questionable-innovations/arcade-chess/docs/WhitePCB_RedGreen.png

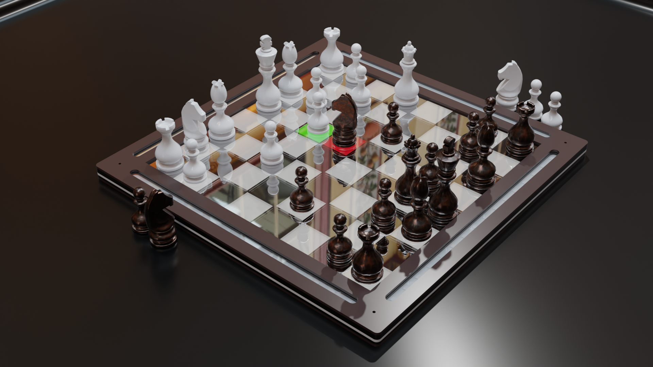
docs/WhitePCB_RedGreen.png
