questionable-innovations/arcade-chess/docs/WoodBoard.webp

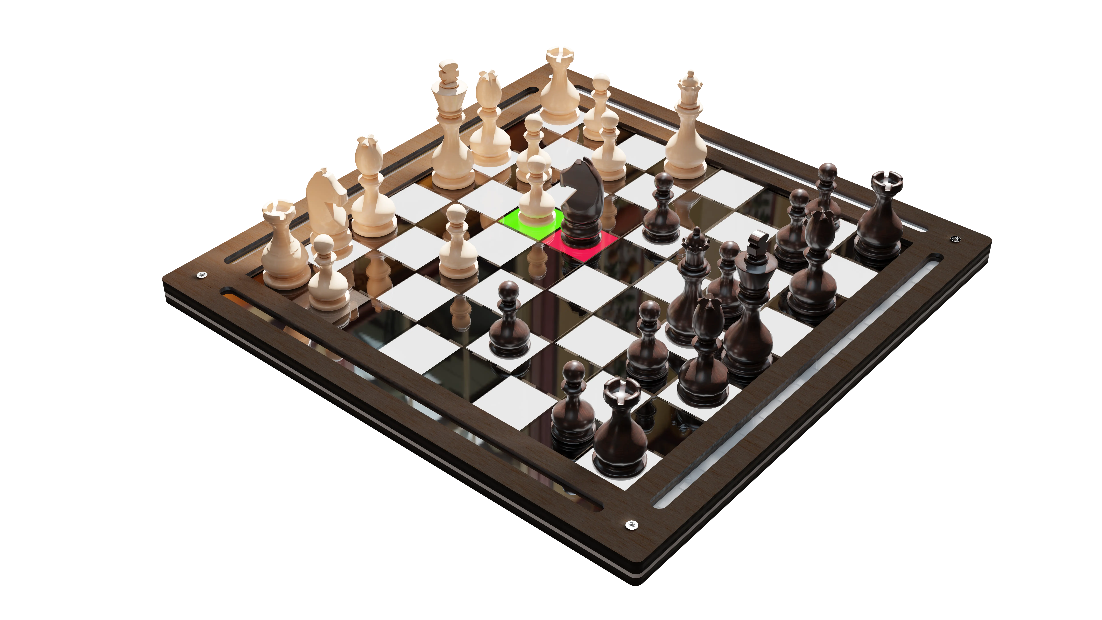
docs/WoodBoard.webp
