questionable-innovations/arcade-chess/docs/PCB-3D.png

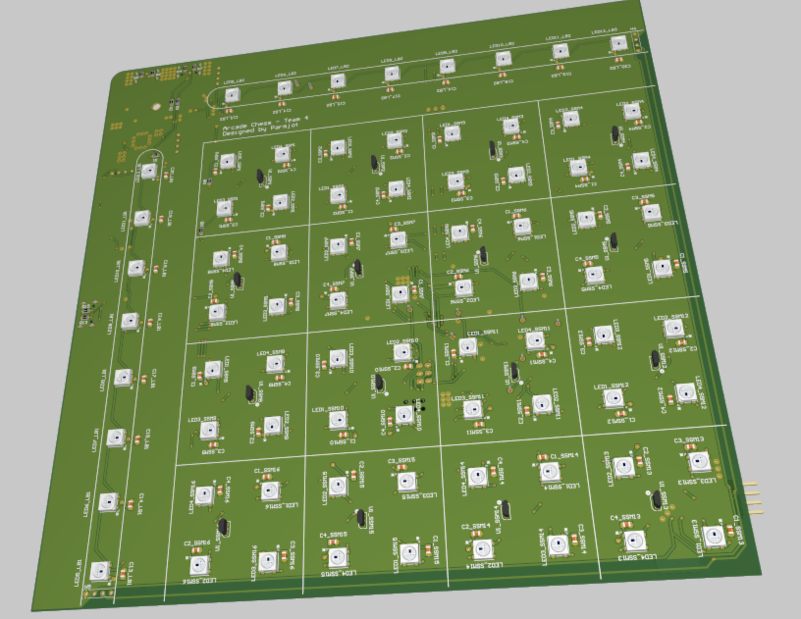
docs/PCB-3D.png
