questionable-innovations/arcade-chess/docs/TeamTwo_ArcadeChess.pdf

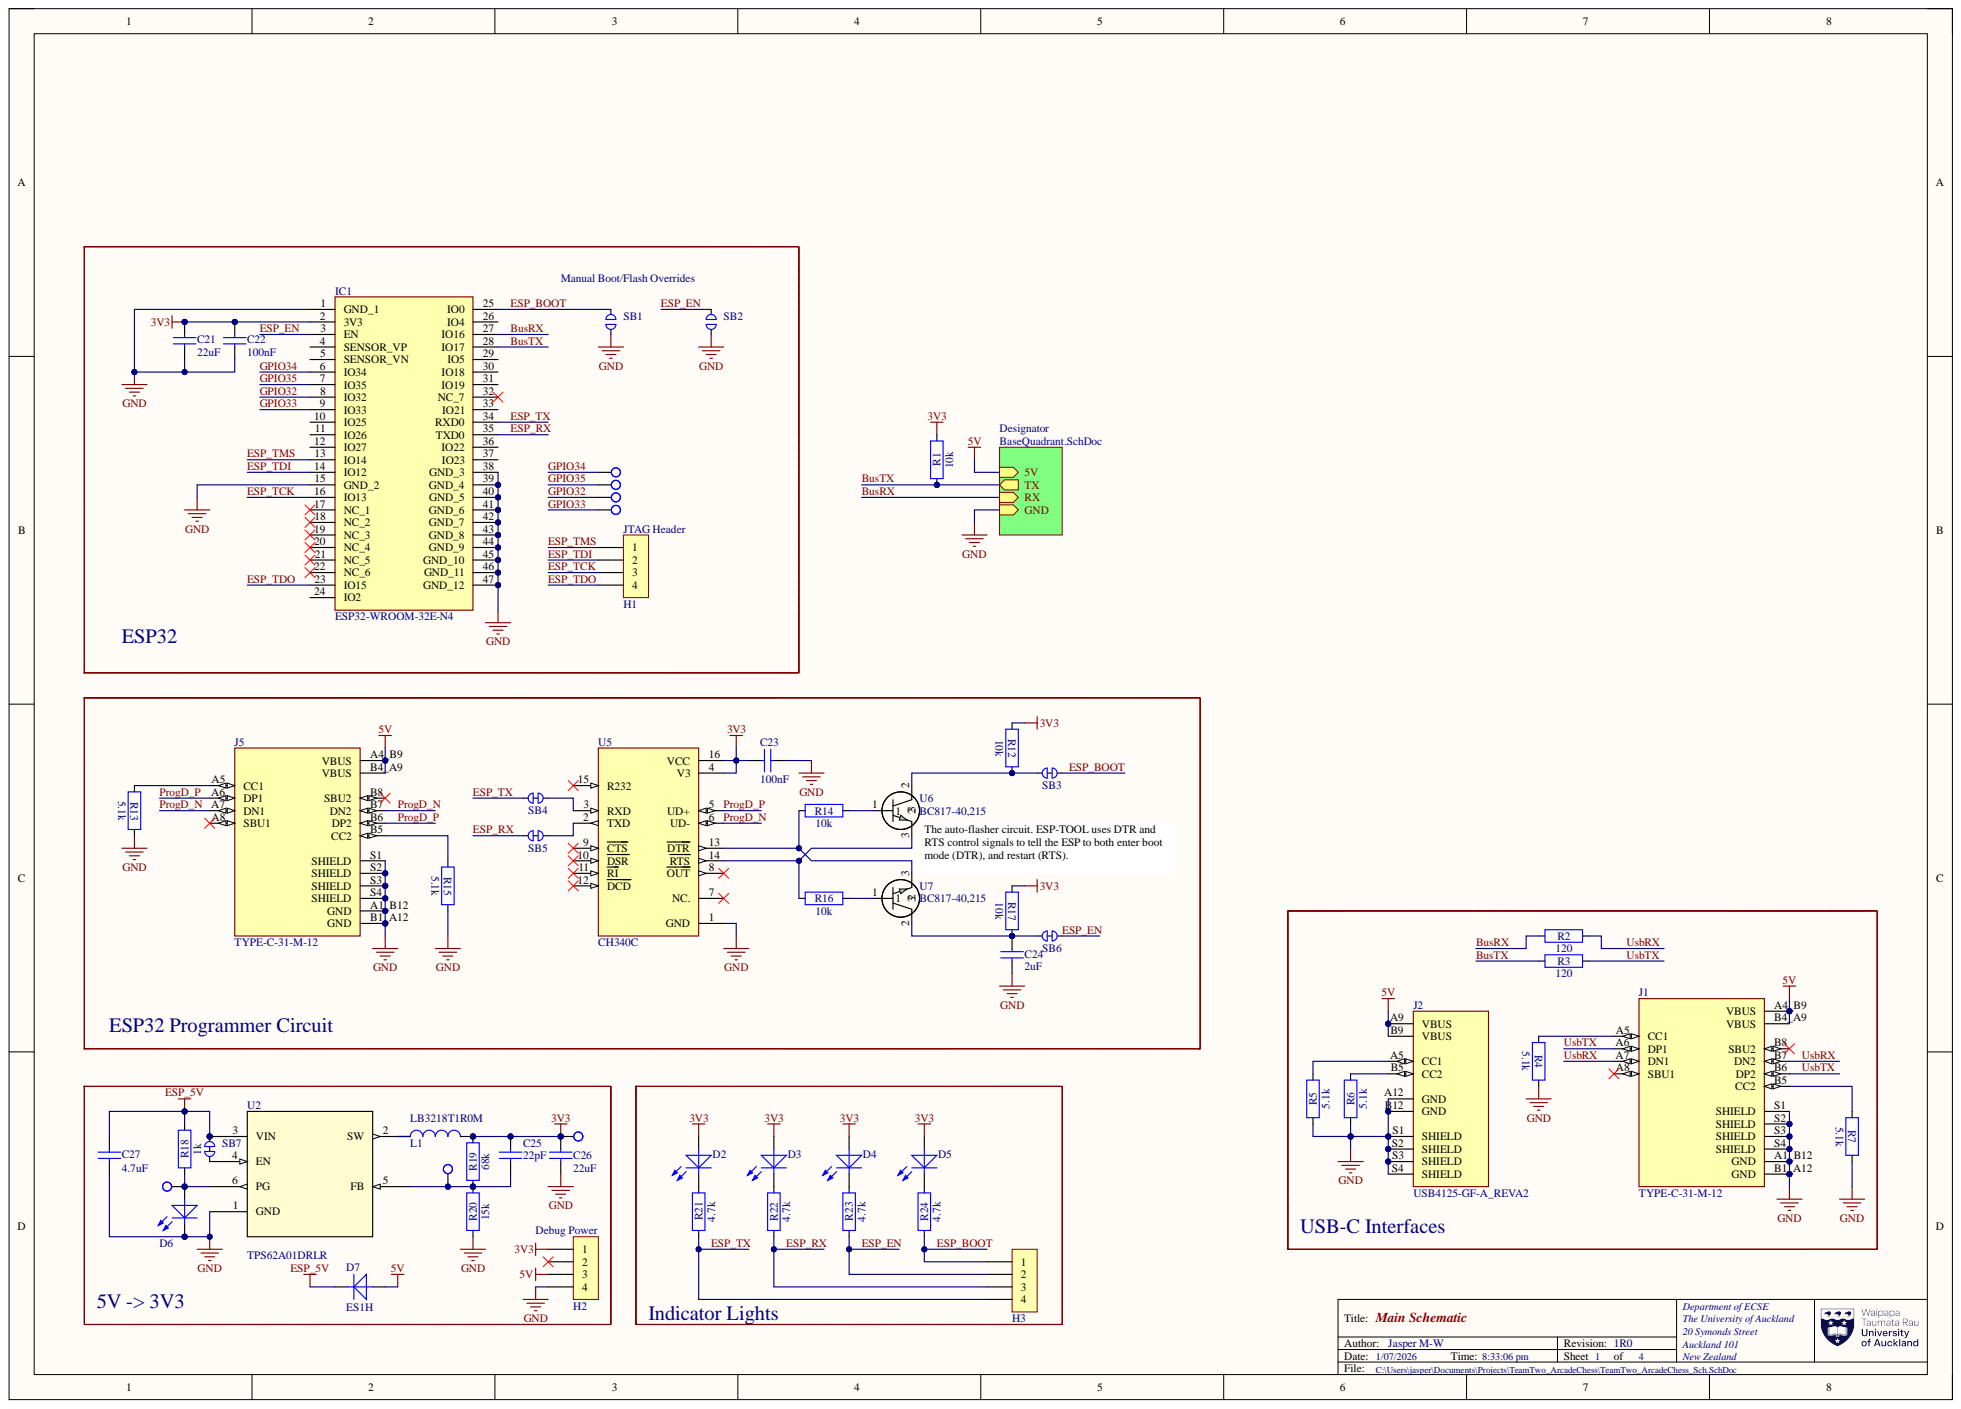
[picture p4: page 1]

C2 1 | ESP_E N C2 | 3

signals to tell the

ESP-TOOL uses DTR and
ESP to both enter boot

mode (DTR), and restart (R

GND A12 GND B12

Department of ECSE
The University of Auckland
20 Symonds Street
Auckland 101

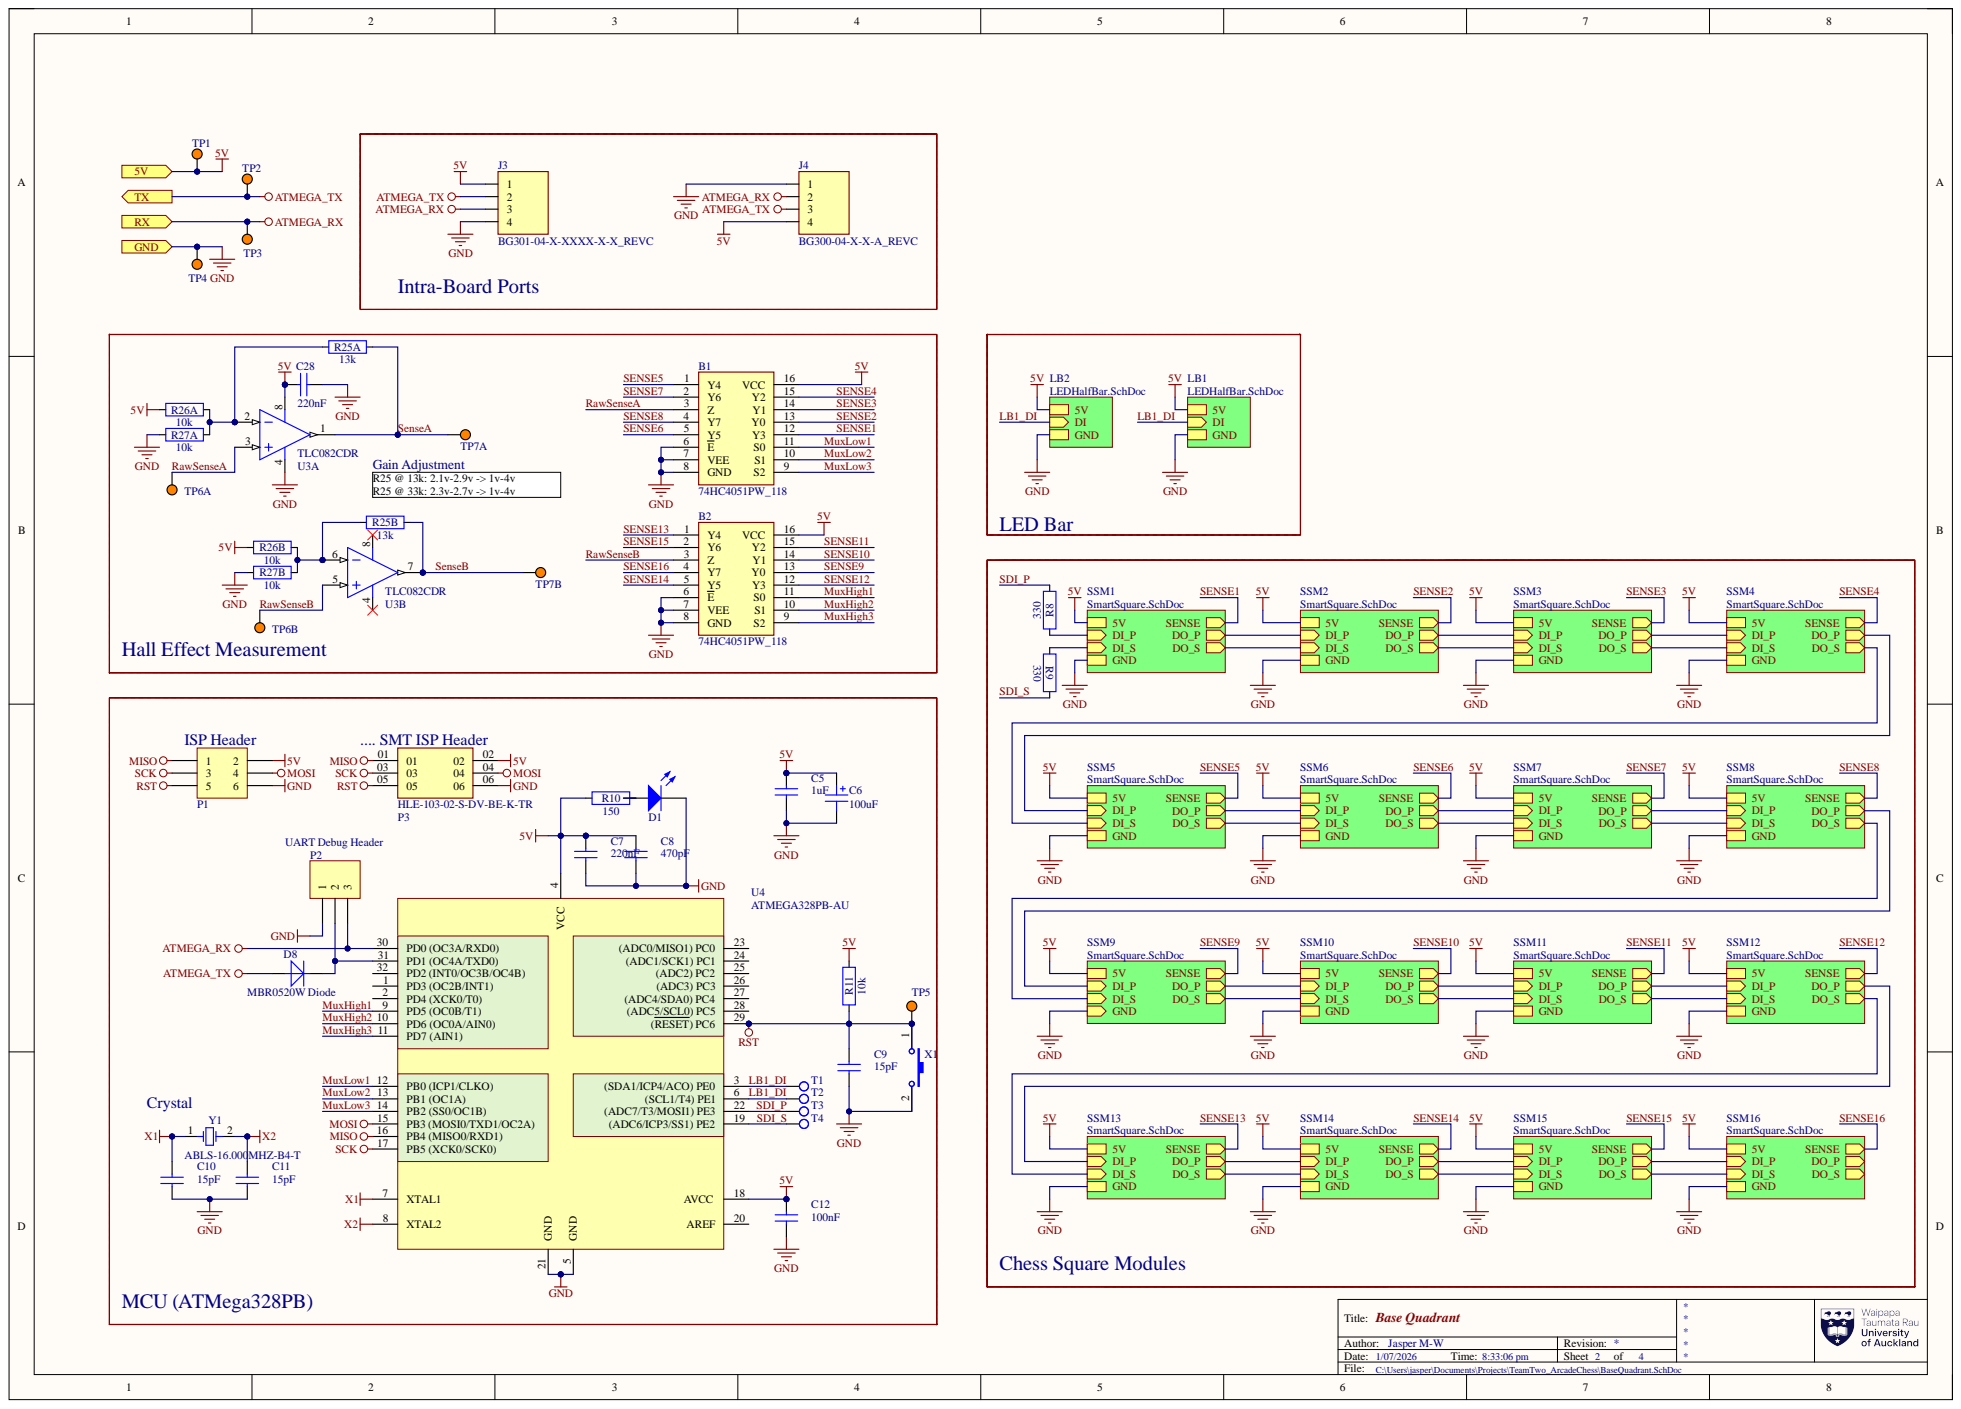
[picture p5: page 2]

HLE-103-02-S-DV-BE-K-TR

Jasper M-W
C:\Users\jasper\Documents\Projects\TeamTwo_ArcadeChess\BaseQuadrant.SchDoc

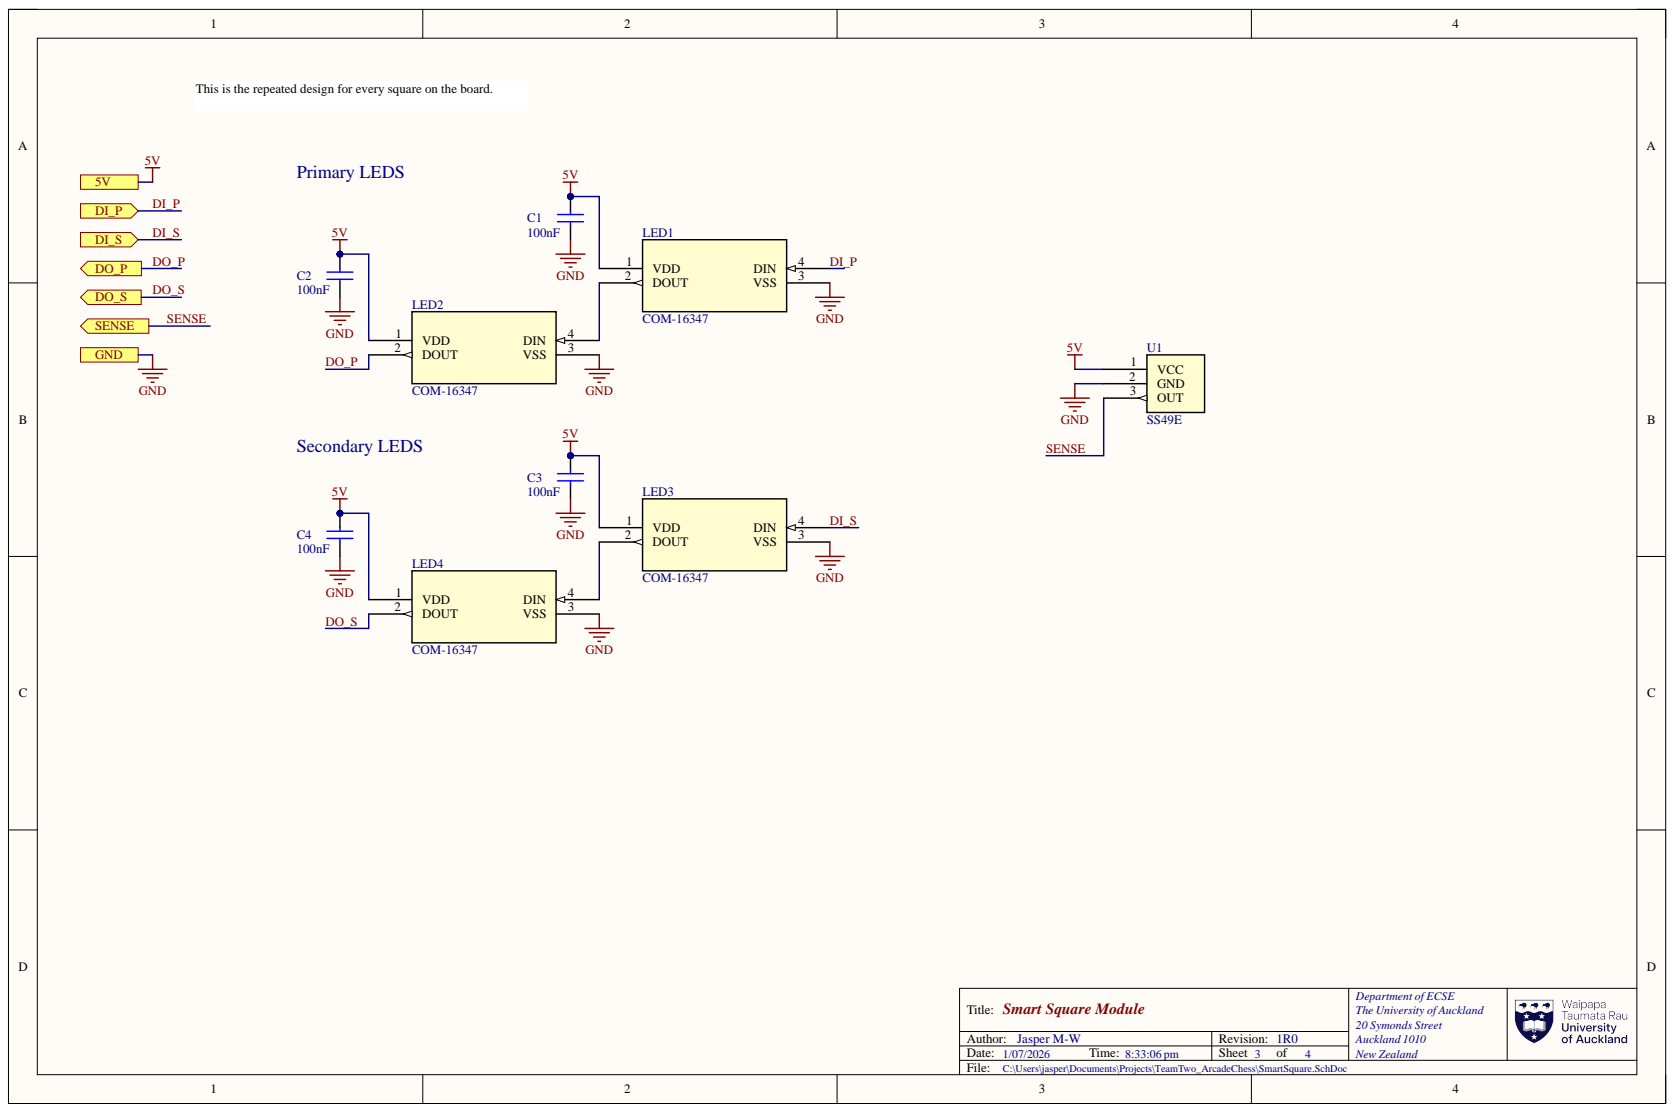
[picture p6: page 3]

This is the repeated design for every square on the board.

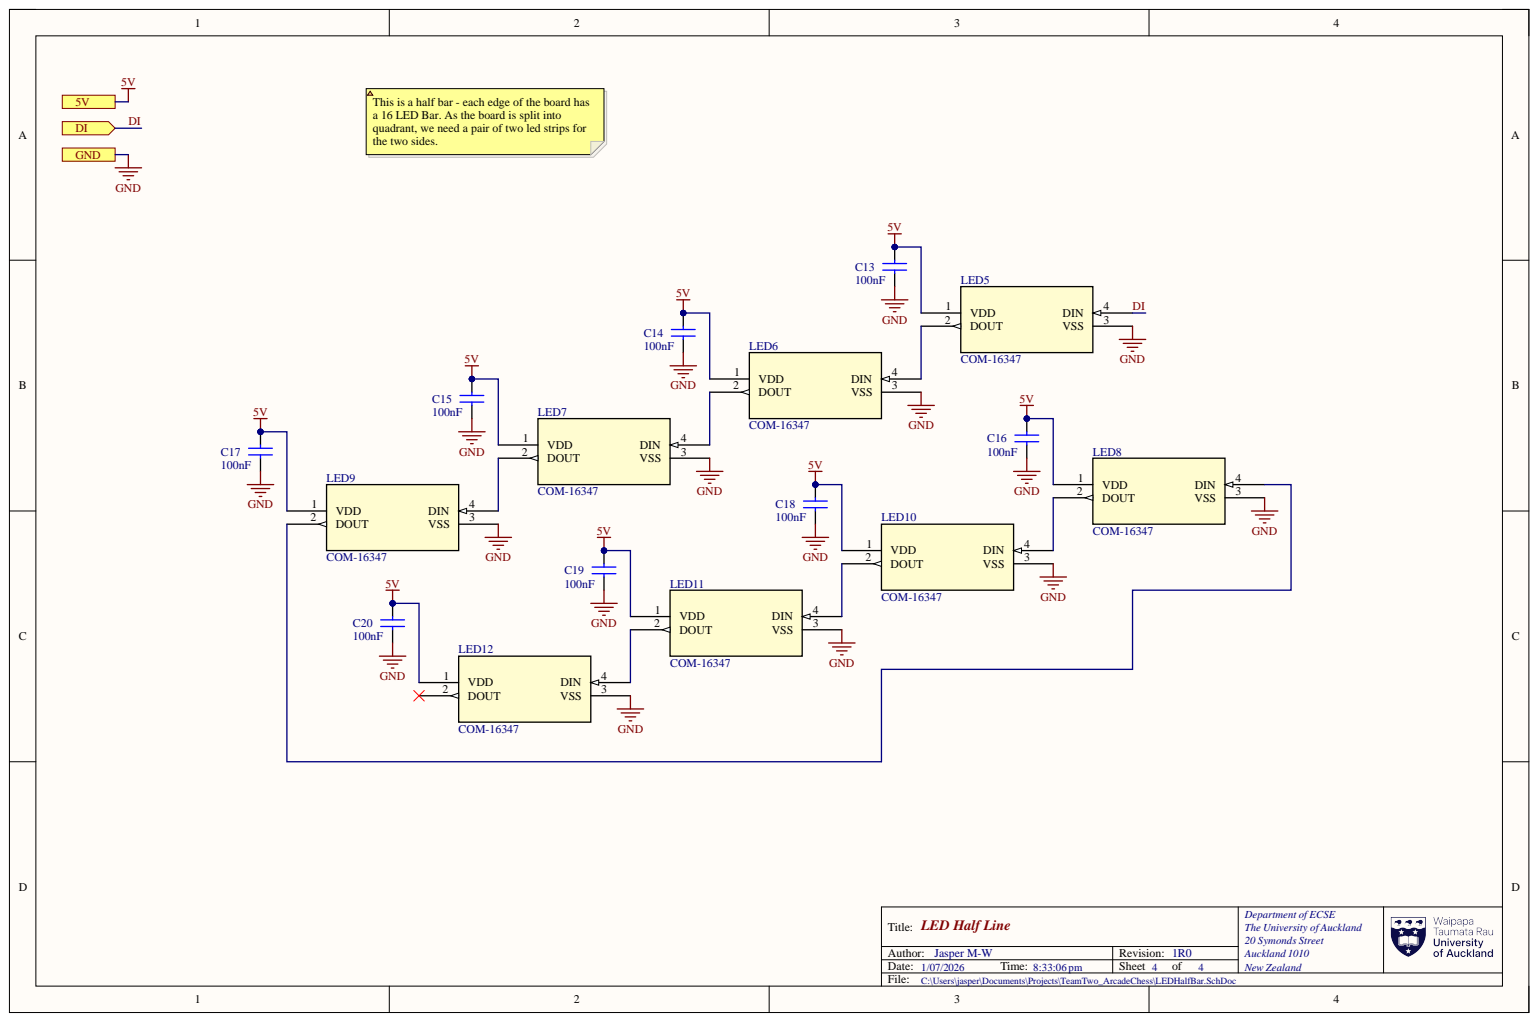
[picture p7: page 4]

This is a half bar - each edge of the board has
a 16 LED Bar. As the board is split into
quadrant, we need a pair of two led strips for
the two sides.

Department of ECSE
The University of Auckland
20 Symonds Street
Auckland 1010

Jasper M-W
C:\Users\jasper\Documents\Projects\TeamTwo_ArcadeChess\LEDHalfBar.SchDoc
