questionable-innovations/arcade-chess/server/src/game/positions.rs

//! The puzzle deck.
//!
//! The miner (`position-miner/`) already produces exactly what puzzle mode
//! needs and already emits JSON, so the contract with that workstream is one
//! command:
//!
//! ```sh
//! arcpos dump position-miner/data/curated.arcpos --json -n 100000 \
//!     > server/positions.json
//! ```
//!
//! Note `-n` defaults to 20 (`position-miner/src/main.rs`); without raising it
//! past the record count you silently get a twenty-position file.
//!
//! Both files are committed — the curated `.arcpos` is un-ignored specifically
//! so the JSON can be regenerated from a clean clone — because CapRover builds
//! from git and the deployed container gets whatever is in the tree.
//!
//! Loading never fails fatally. A missing, empty or malformed deck falls back to
//! the eight hand-checked endgames in `positions.fallback.json`, compiled into
//! the binary. Game mode must not go down with the content pipeline.

use std::collections::VecDeque;

use serde_json::Value;
use shakmaty::fen::Fen;
use shakmaty::{CastlingMode, Chess, Position};

use crate::util::random_u64;

/// The hand-checked emergency deck, compiled in so that a missing, empty or
/// malformed deck at runtime is a log line rather than a dead game mode. It is
/// deliberately *not* the file the Dockerfile ships to `POSITIONS_PATH`: keeping
/// the two separate is what lets `Deck::fallback` tell "playing the mined deck"
/// apart from "the mined deck did not load".
const EMBEDDED: &str = include_str!("../../positions.fallback.json");
/// Pieces a dealt position may have. This is the miner's format ceiling
/// (`position-miner/src/format.rs`, `MAX_PIECES`) — the packed nibble array
/// cannot describe a larger board, so nothing the miner emits can exceed it.
/// The miner's own `--max-pieces` sits below this; the check is here to catch a
/// hand-edited or foreign deck, not to re-impose the miner's taste.
const MAX_PIECES: usize = 16;
/// How many recently dealt positions to avoid repeating.
const RECENT_MEMORY: usize = 8;

#[derive(Clone, Debug)]
pub struct PositionRecord {
    pub id: String,
    pub fen: String,
    /// Engine score at mining time, white POV, when the record carries one.
    pub verified_cp: Option<i32>,
    /// How far the second-best root move falls behind the best — the sharpness
    /// signal the miner ranks on.
    pub drop_cp: Option<i32>,
}
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
