questionable-innovations/arcade-chess/(commit log)

2026-07-13 FastLED + Dynamic board unplugging
2026-07-13 Heatmap for frontend
2026-07-13 Switch to pnpm :P
2026-07-13 Switch to URBOOT flash protocol
2026-07-15 Add chess-clock prototype (Nano + MD_Parola display)
    Standalone PlatformIO project for the LED-matrix text rendering
    prototype; stopwatch/timer logic to follow.
2026-07-16 Timer function implemented + render text clear bug fixed
    [main.cpp]
2026-07-25 Today's features and fixes
    [avr_flasher.cpp, avr_flasher.h, bringup_config.h, bus_manager.cpp, bus_manager.h, firmware_handoff.cpp, firmware_update.cpp, firmware_update.h]
2026-07-25 buttons implemented in chess clock - untested
2026-07-26 Implement board mapping
2026-07-26 factor thy board
